kssethurathnamSMSV47/AQUA-CORE-ESP32/Graphs/case1_cumulative_volume.png

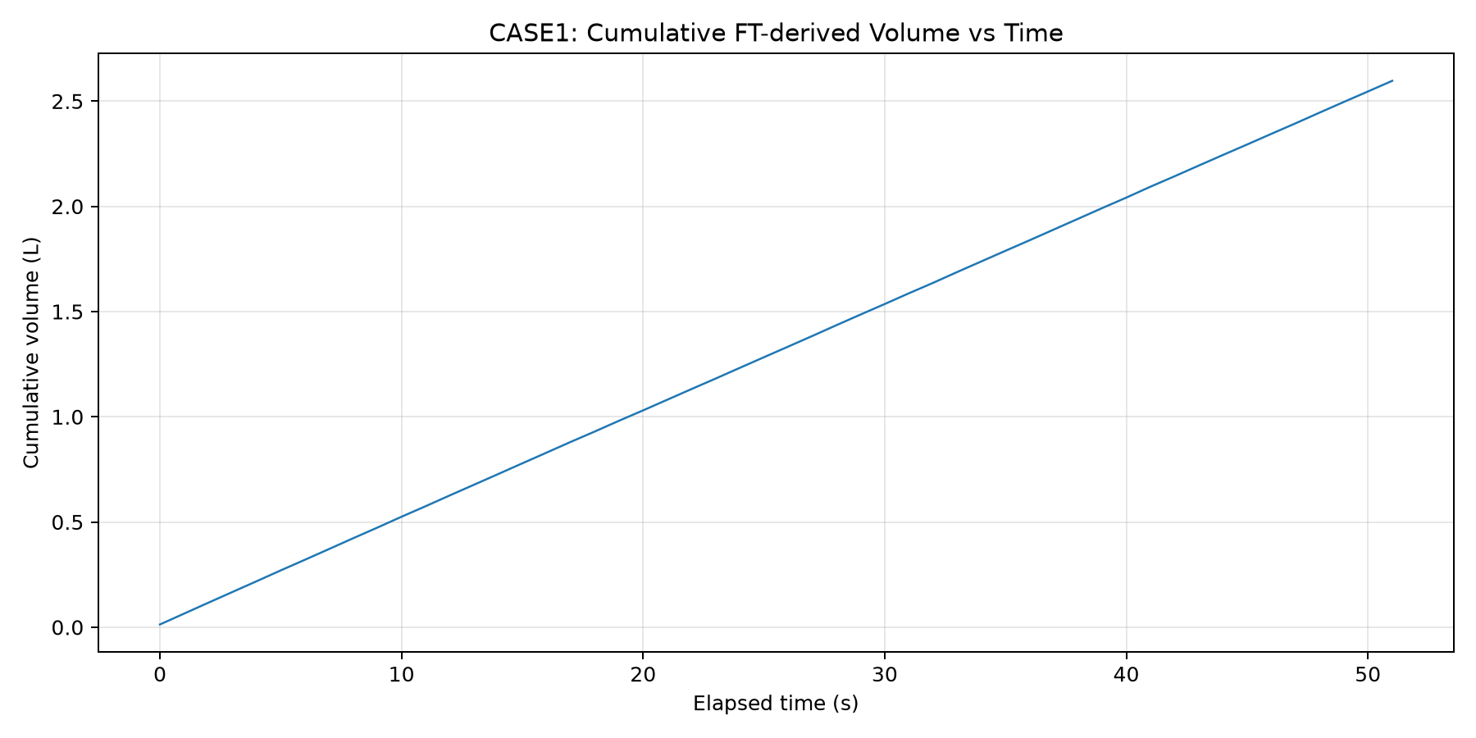
Graphs/case1_cumulative_volume.png
