kssethurathnamSMSV47/AQUA-CORE-ESP32/Graphs/case1_flow_rate_vs_time.png

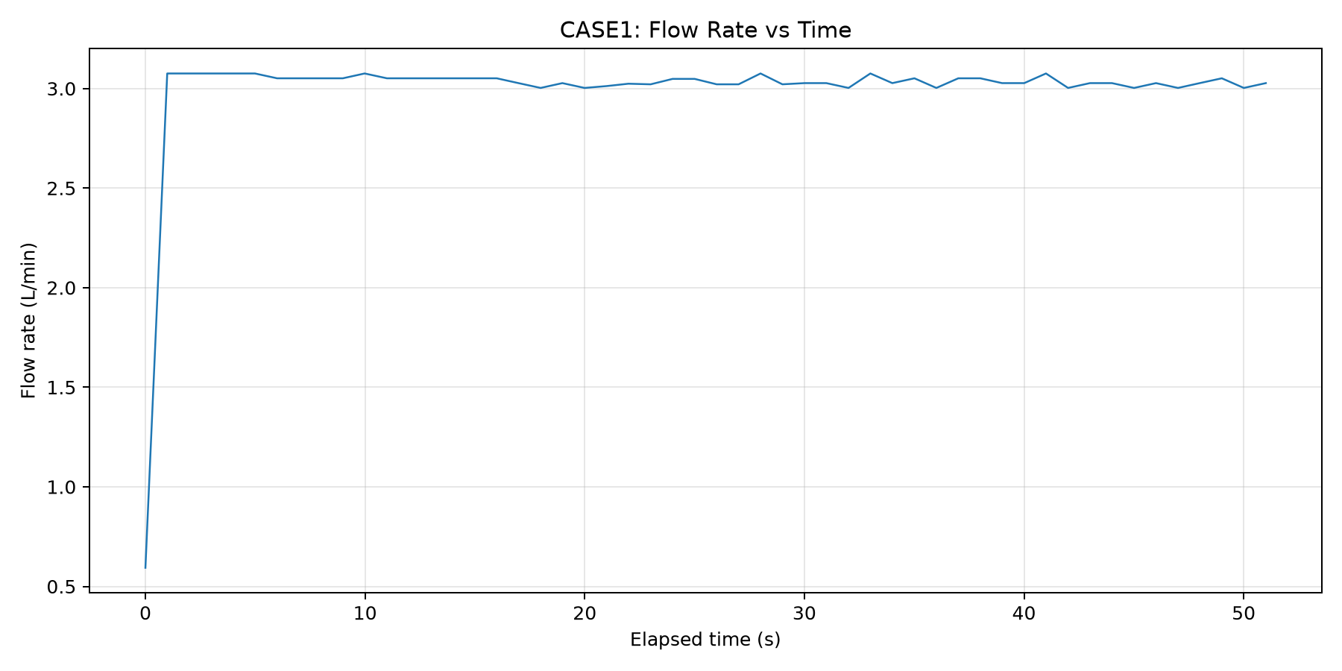
Graphs/case1_flow_rate_vs_time.png
