kssethurathnamSMSV47/AQUA-CORE-ESP32/Graphs/case2_cumulative_volume.png

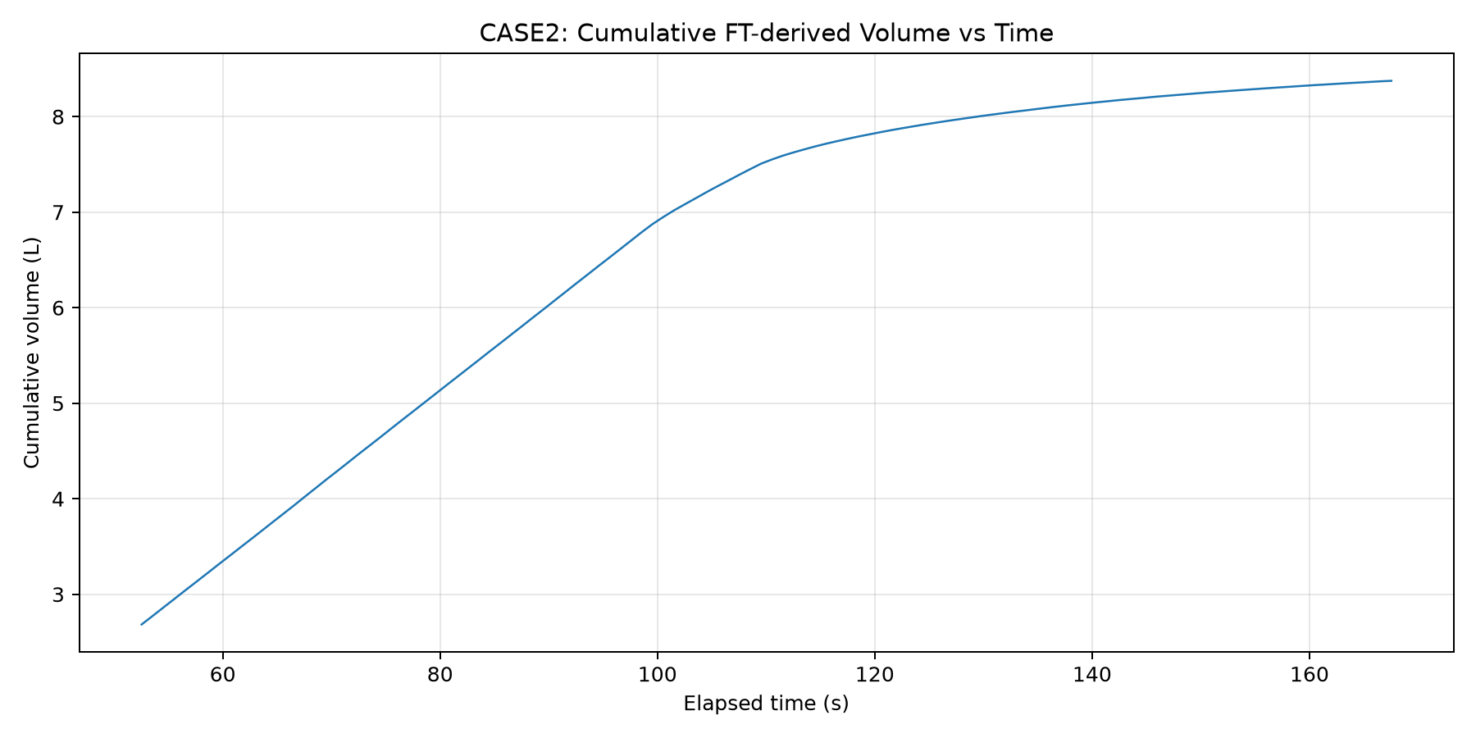
Graphs/case2_cumulative_volume.png
