kssethurathnamSMSV47/AQUA-CORE-ESP32/Graphs/ft01_flow_vs_frequency.png

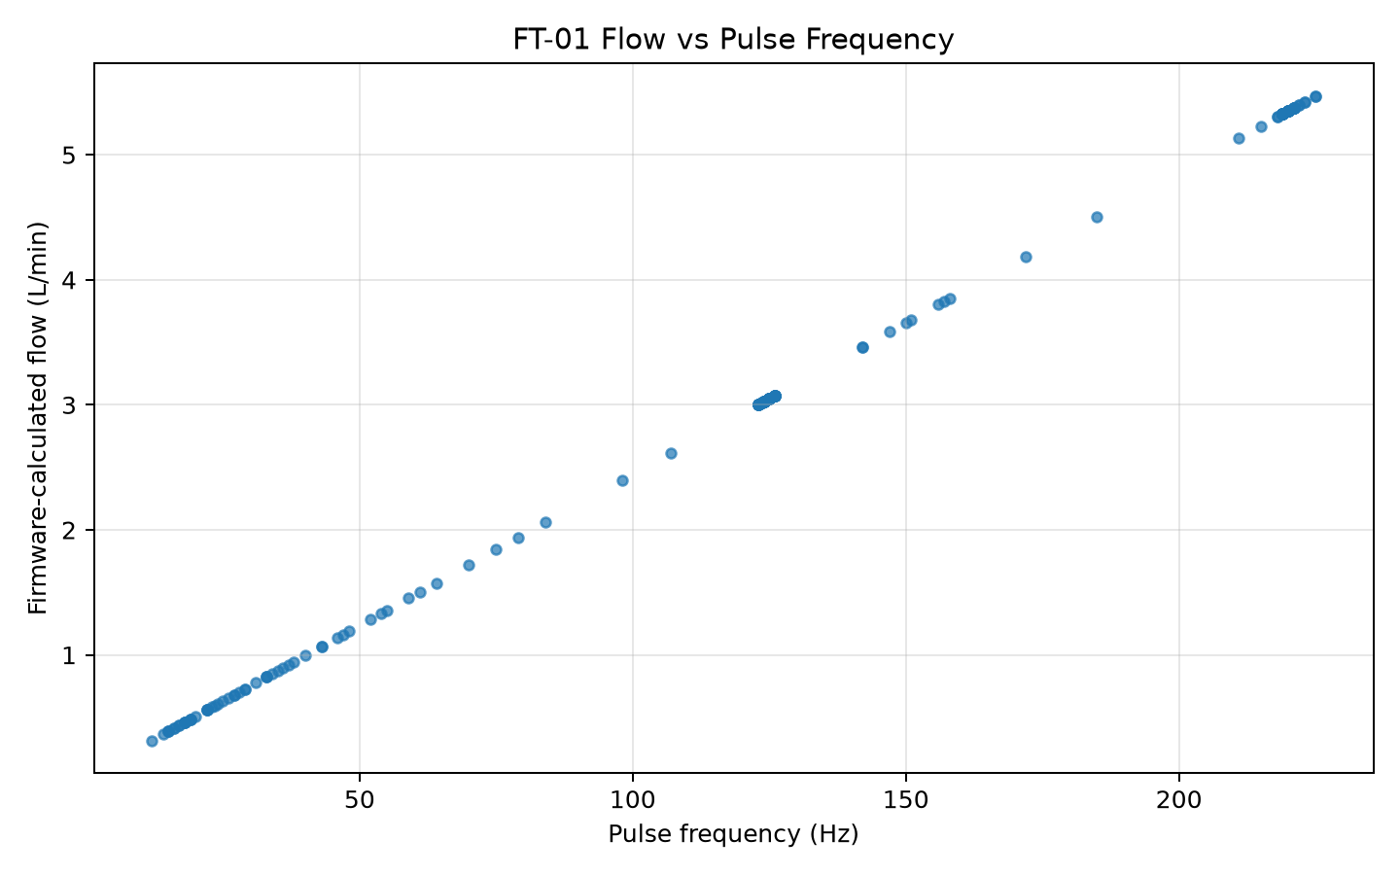
Graphs/ft01_flow_vs_frequency.png
