kssethurathnamSMSV47/AQUA-CORE-ESP32/experiment_video/readme.md

This is the folder for the experiment videos and in this the drive links for the respective videos are shared
This includes both the journey video and also the experiment video (case1 and case2 as well as performing flow rate v/s ball valve position)
