kssethurathnamSMSV47/AQUA-CORE-ESP32/experiment_video/complete_experiment_explaination_video/explaination_video_README.md

We are team Nova Thinkers (Team id : LRC-26-0050) 
Complete Experiment explaination video link : https://drive.google.com/file/d/16r2ey3BW5-Ra5XUtoijbtHDlPwqKOgTw/view?usp=sharing
The experiment explaination contains an introduction, P&ID explaination, architecture explaination, calibration, case1 and case2 explaination, flow rate v/s ball valve position
and the explaination and justifcation of the results of all the experiments
