kssethurathnamSMSV47/AQUA-CORE-ESP32/experiment_video/journey_video/journey_video_README.md

We are team Nova Thinkers (Team id : LRC-26-0050)
Complete journey video link : https://drive.google.com/file/d/1mIlgGlXgmaxjqB6Jj82Wy96oes1z7VvI/view?usp=sharing 
This video includes the whole journey of our team starting from unboxing the hardware received and includes our whole experiment setup and works
