kssethurathnamSMSV47/AQUA-CORE-ESP32/(commit log)

2026-10-15 added case1 and case2 combined run ESP32 code
2026-10-15 created case1 and case2 commit ESP32 code
2026-10-15 Add standalone ball-valve flow characterization sketch
    This sketch implements a standalone ball-valve flow characterization system for measuring flow rates and volumes based on FT-01 pulses. It includes command handling for valve position settings, status reporting, and safety instructions.
2026-10-15 Add ball valve flow logger and report script
    This script logs and reports data from a ball valve flow experiment, including serial communication with an ESP32 device, data parsing, and report generation.
2026-10-15 Add case1_case2_logger.py for data logging and reporting
    This script logs data from an ESP32 device for two cases, generates plots, and creates a Word report. It includes command handling for various operations and calibration support.
2026-10-15 added the stage2 hardware experiment team report
2026-10-15 added the result graphs generated
    added the graphs for case1 case2 and the flow rate control by ball valve position generated by the python scripts
2026-10-15 Add readme for experiment video folder
    This folder contains links to experiment videos, including journey and case videos.
